peppapighs/HE16/HE16/HE16.kicad_pcb

## KiCad design HE16/HE16.kicad_pcb (2025-07-30)

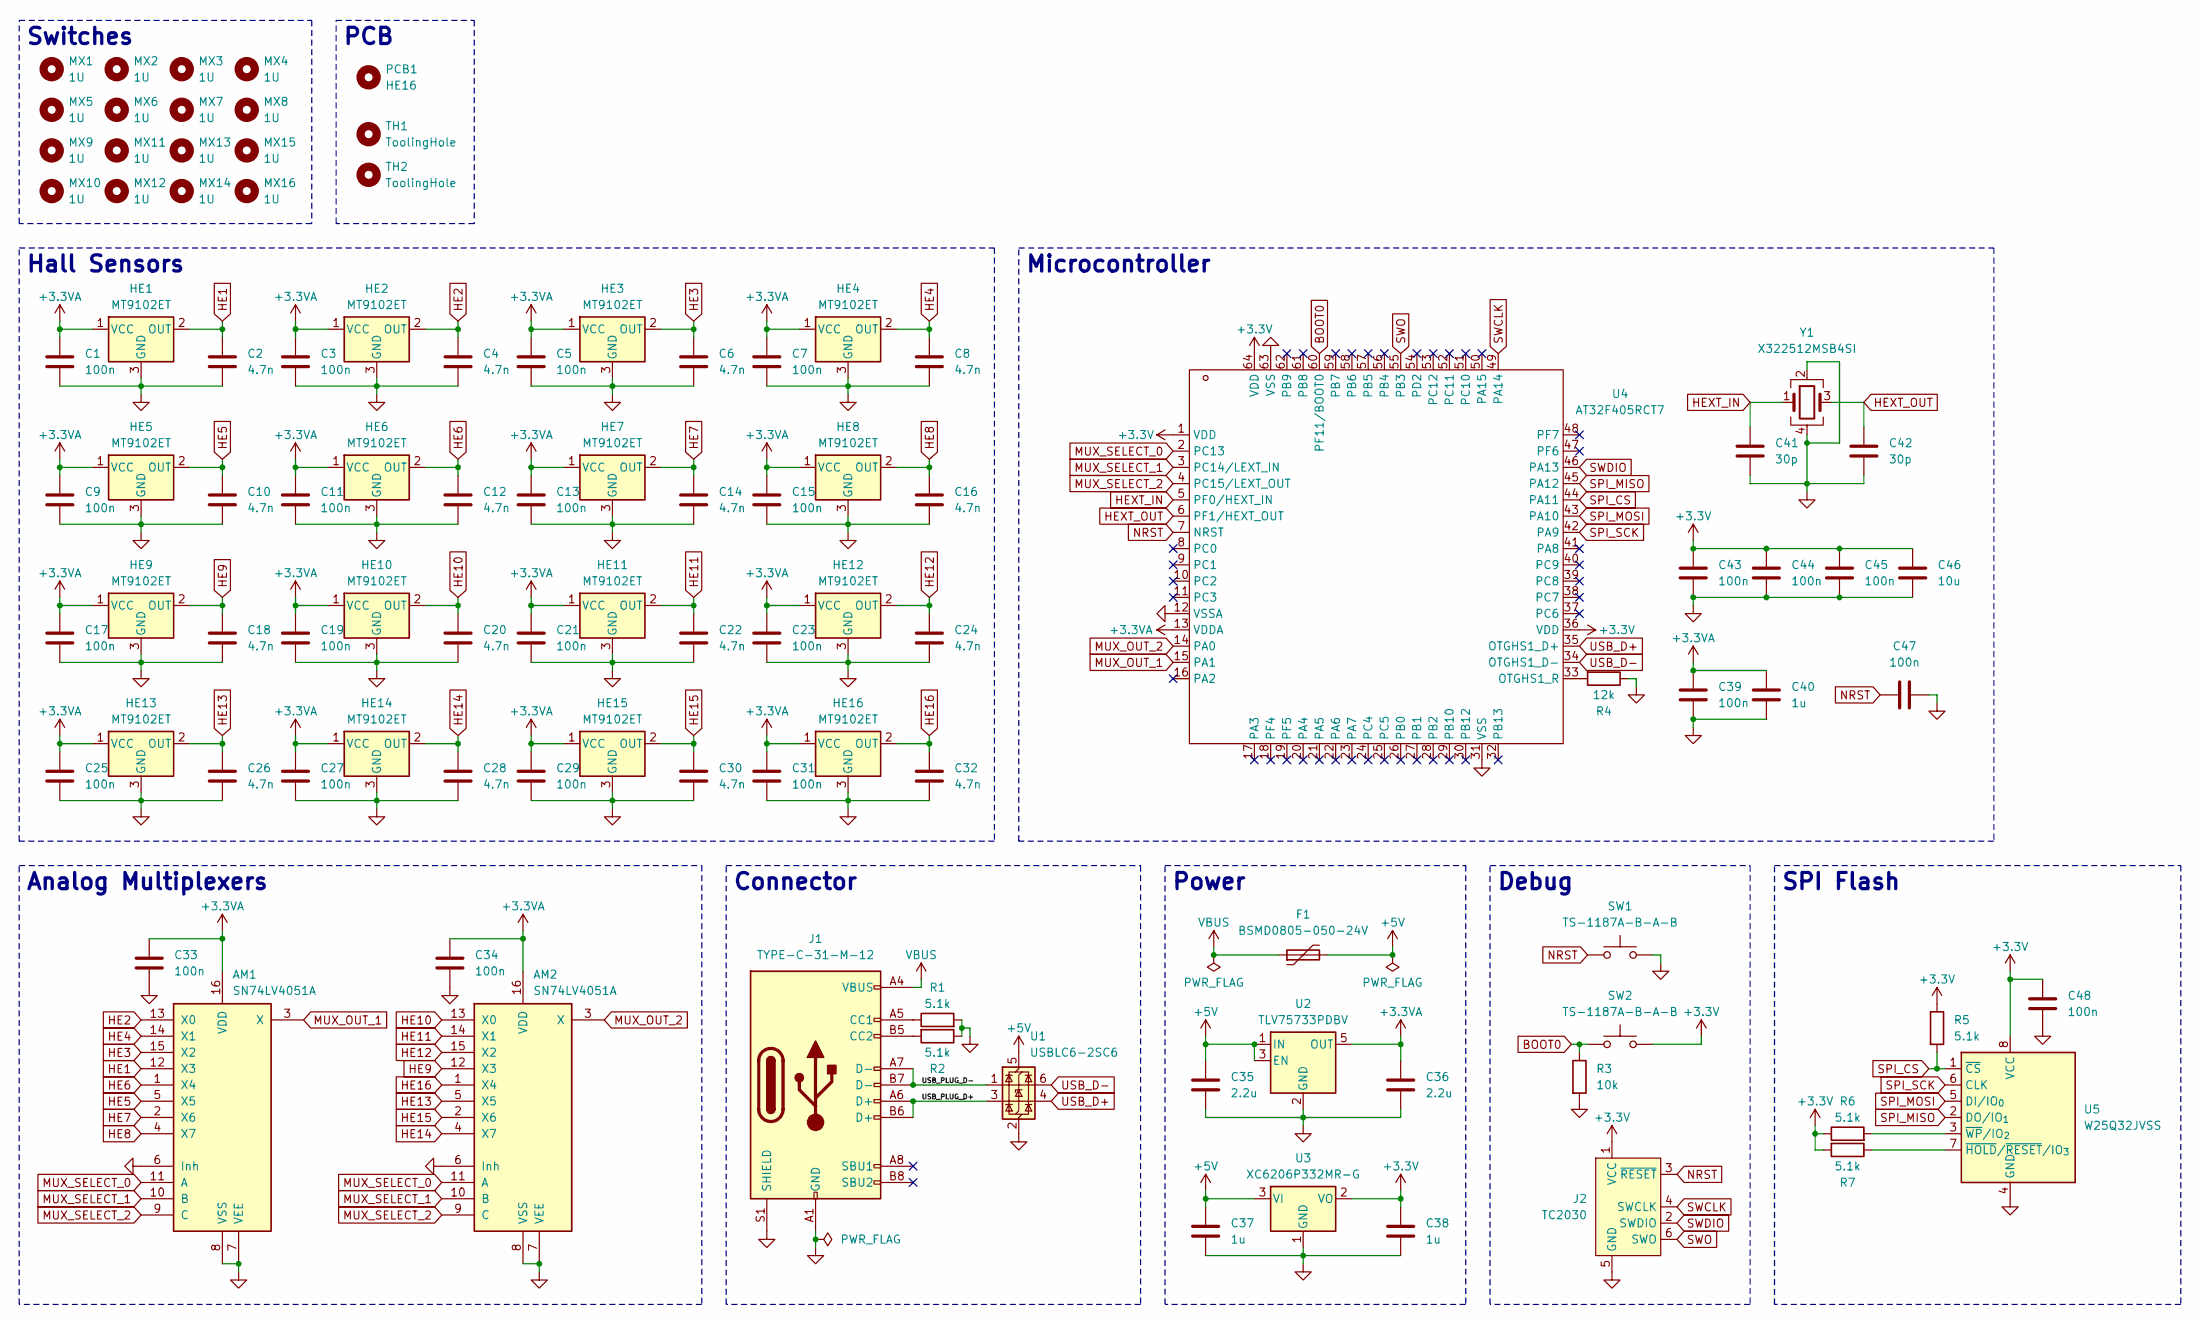
[picture p1: schematic HE16.kicad_sch]

Parts:
AM1, AM2: SN74LV4051A; TSSOP-16_4.4x5mm_P0.65mm
C1, C3, C5, C7, C9, C11, C13, C15, C17, C19, C21, C23, C25, C27, C29, C31, C33, C34, C39, C43, C44, C45, C47, C48: 100n; C_0402_1005Metric
C2, C4, C6, C8, C10, C12, C14, C16, C18, C20, C22, C24, C26, C28, C30, C32: 4.7n; C_0402_1005Metric
C35, C36: 2.2u; C_0603_1608Metric
C37, C38, C40: 1u; C_0603_1608Metric
C41, C42: 30p; C_0603_1608Metric
C46: 10u; C_0603_1608Metric
F1: BSMD0805-050-24V; Fuse_0805_2012Metric
HE1, HE2, HE3, HE4, HE5, HE6, HE7, HE8, HE9, HE10, HE11, HE12, HE13, HE14, HE15, HE16: MT9102ET; SOT-23-3
J1: TYPE-C-31-M-12; USB_C_Receptacle_HRO_TYPE-C-31-M-12
J2: TC2030; Tag-Connect_TC2030-IDC-FP_2x03_P1.27mm_Vertical
MX1, MX2, MX3, MX4, MX5, MX6, MX7, MX8, MX9, MX10, MX11, MX12, MX13, MX14, MX15, MX16: 1U; MX-1U
PCB1: HE16
R1, R2, R5, R6, R7: 5.1k; R_0402_1005Metric
R3: 10k; R_0402_1005Metric
R4: 12k; R_0402_1005Metric
SW1, SW2: TS-1187A-B-A-B; SW_Push_1P1T_XKB_TS-1187A
TH1, TH2: ToolingHole
U1: USBLC6-2SC6; SOT-23-6
U2: TLV75733PDBV; SOT-23-5
U3: XC6206P332MR-G; SOT-23-3
U4: AT32F405RCT7; LQFP-64_10x10mm_P0.5mm
U5: W25Q32JVSS; SOIC-8_5.3x5.3mm_P1.27mm
Y1: X322512MSB4SI; Crystal_SMD_3225-4Pin_3.2x2.5mm

Connections:
+3.3V: C38.1, C43.1, C44.1, C45.1, C46.1, C48.1, J2.1 (VCC), R5.1, R6.1, R7.2, SW2.2, U3.2 (VO), U4.1 (VDD), U4.36 (VDD), U4.64 (VDD), U5.8 (VCC)
+3.3VA: AM1.16 (VDD), AM2.16 (VDD), C1.1, C3.1, C5.1, C7.1, C9.1, C11.1, C13.1, C15.1, C17.1, C19.1, C21.1, C23.1, C25.1, C27.1, C29.1, C31.1, C33.1, C34.1, C36.1, C39.1, C40.1, HE1.1 (VCC), HE2.1 (VCC), HE3.1 (VCC), HE4.1 (VCC), HE5.1 (VCC), HE6.1 (VCC), HE7.1 (VCC), HE8.1 (VCC), HE9.1 (VCC), HE10.1 (VCC), HE11.1 (VCC), HE12.1 (VCC), HE13.1 (VCC), HE14.1 (VCC), HE15.1 (VCC), HE16.1 (VCC), U2.5 (OUT), U4.13 (VDDA)
+5V: C35.1, C37.1, F1.2, U1.5 (VBUS), U2.1 (IN), U2.3 (EN), U3.3 (VI)
/USB_PLUG_D+: J1.A6 (D+), J1.B6 (D+), U1.3 (I/O2)
/USB_PLUG_D-: J1.A7 (D-), J1.B7 (D-), U1.1 (I/O1)
BOOT0: R3.1, SW2.1, U4.60 (PF11/BOOT0)
GND: AM1.6 (Inh), AM1.7 (VEE), AM1.8 (VSS), AM2.6 (Inh), AM2.7 (VEE), AM2.8 (VSS), C1.2, C2.2, C3.2, C4.2, C5.2, C6.2, C7.2, C8.2, C9.2, C10.2, C11.2, C12.2, C13.2, C14.2, C15.2, C16.2, C17.2, C18.2, C19.2, C20.2, C21.2, C22.2, C23.2, C24.2, C25.2, C26.2, C27.2, C28.2, C29.2, C30.2, C31.2, C32.2, C33.2, C34.2, C35.2, C36.2, C37.2, C38.2, C39.2, C40.2, C41.2, C42.2, C43.2, C44.2, C45.2, C46.2, C47.2, C48.2, HE1.3 (GND), HE2.3 (GND), HE3.3 (GND), HE4.3 (GND), HE5.3 (GND), HE6.3 (GND), HE7.3 (GND), HE8.3 (GND), HE9.3 (GND), HE10.3 (GND), HE11.3 (GND), HE12.3 (GND), HE13.3 (GND), HE14.3 (GND), HE15.3 (GND), HE16.3 (GND), J1.A1 (GND), J1.A12 (GND), J1.B1 (GND), J1.B12 (GND), J1.S1 (SHIELD), J2.5 (GND), R1.2, R2.1, R3.2, R4.1, SW1.2, U1.2 (GND), U2.2 (GND), U3.1 (GND), U4.12 (VSSA), U4.31 (VSS), U4.63 (VSS), U5.4 (GND), Y1.2, Y1.4
HE1: AM1.12 (X3), C2.1, HE1.2 (OUT)
HE2: AM1.13 (X0), C4.1, HE2.2 (OUT)
HE3: AM1.15 (X2), C6.1, HE3.2 (OUT)
HE4: AM1.14 (X1), C8.1, HE4.2 (OUT)
HE5: AM1.5 (X5), C10.1, HE5.2 (OUT)
HE6: AM1.1 (X4), C12.1, HE6.2 (OUT)
HE7: AM1.2 (X6), C14.1, HE7.2 (OUT)
HE8: AM1.4 (X7), C16.1, HE8.2 (OUT)
HE9: AM2.12 (X3), C18.1, HE9.2 (OUT)
HE10: AM2.13 (X0), C20.1, HE10.2 (OUT)
HE11: AM2.14 (X1), C22.1, HE11.2 (OUT)
HE12: AM2.15 (X2), C24.1, HE12.2 (OUT)
HE13: AM2.5 (X5), C26.1, HE13.2 (OUT)
HE14: AM2.4 (X7), C28.1, HE14.2 (OUT)
HE15: AM2.2 (X6), C30.1, HE15.2 (OUT)
HE16: AM2.1 (X4), C32.1, HE16.2 (OUT)
HEXT_IN: C41.1, U4.5 (PF0/HEXT_IN), Y1.1
HEXT_OUT: C42.1, U4.6 (PF1/HEXT_OUT), Y1.3
MUX_OUT_1: AM1.3 (X), U4.15 (PA1)
MUX_OUT_2: AM2.3 (X), U4.14 (PA0)
MUX_SELECT_0: AM1.11 (A), AM2.11 (A), U4.2 (PC13)
MUX_SELECT_1: AM1.10 (B), AM2.10 (B), U4.3 (PC14/LEXT_IN)
MUX_SELECT_2: AM1.9 (C), AM2.9 (C), U4.4 (PC15/LEXT_OUT)
NRST: C47.1, J2.3 (~RESET), SW1.1, U4.7 (NRST)
unnamed: J1.A5 (CC1), R1.1
unnamed: J1.B5 (CC2), R2.2
unnamed: R4.2, U4.33 (OTGHS1_R)
unnamed: R7.1, U5.7 (~HOLD/~RESET/IO_{3})
unnamed: R6.2, U5.3 (~WP/IO_{2})
SPI_CS: R5.2, U4.44 (PA11), U5.1 (~CS)
SPI_MISO: U4.45 (PA12), U5.2 (DO/IO_{1})
SPI_MOSI: U4.43 (PA10), U5.5 (DI/IO_{0})
SPI_SCK: U4.42 (PA9), U5.6 (CLK)
SWCLK: J2.4 (SWCLK), U4.49 (PA14)
SWDIO: J2.2 (SWDIO), U4.46 (PA13)
SWO: J2.6 (SWO), U4.55 (PB3)
USB_D+: U1.4 (I/O2), U4.35 (OTGHS1_D+)
USB_D-: U1.6 (I/O1), U4.34 (OTGHS1_D-)
VBUS: F1.1, J1.A4 (VBUS), J1.A9 (VBUS), J1.B4 (VBUS), J1.B9 (VBUS)

Notes on the sheet:
Switches
Connector
Debug
Microcontroller
Analog Multiplexers
Hall Sensors
PCB
SPI Flash
Power

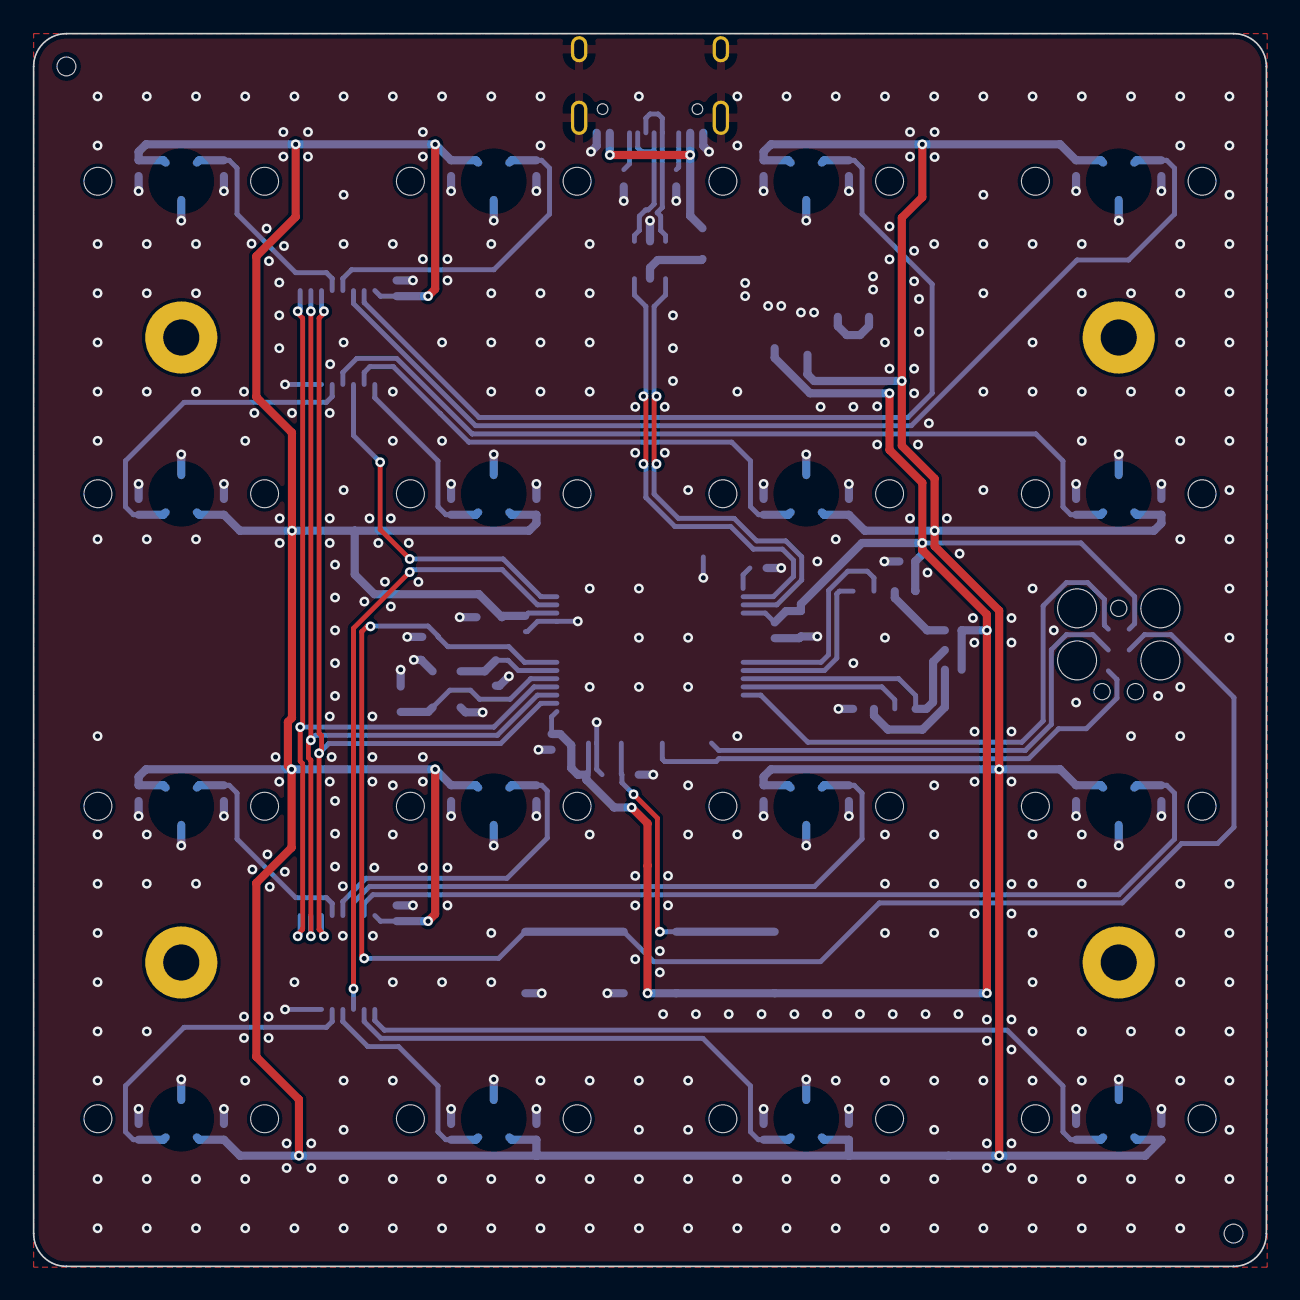
[picture p2: board HE16.kicad_pcb from above]

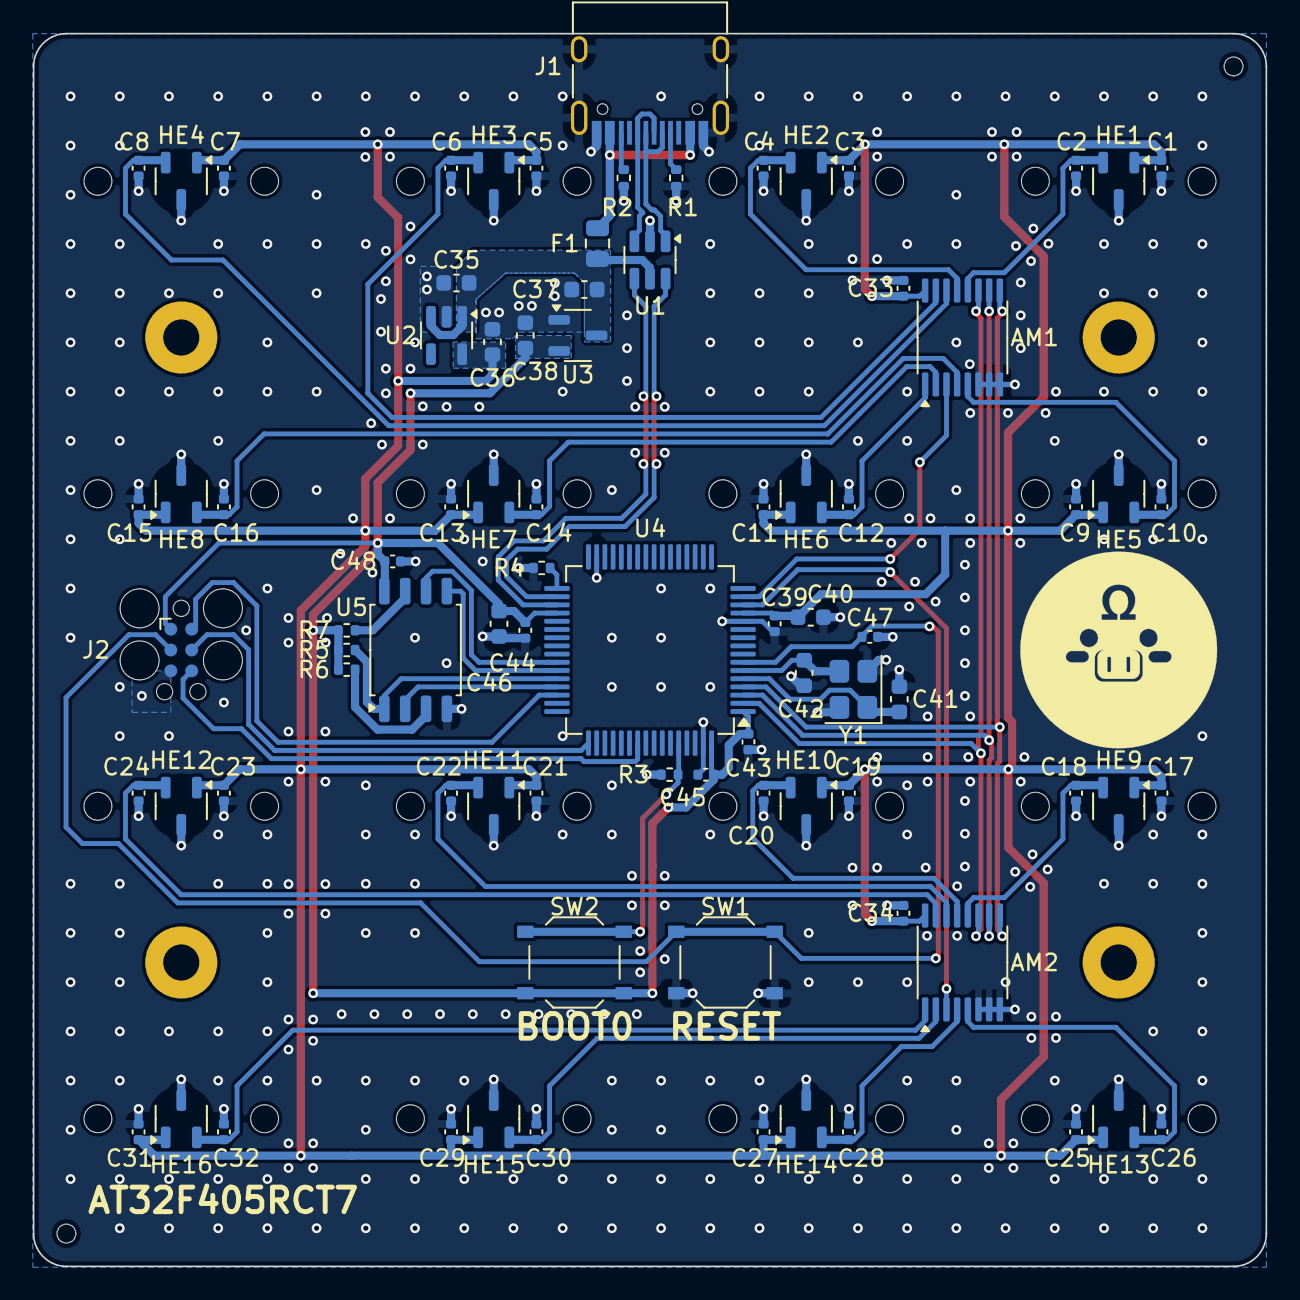
[picture p3: board HE16.kicad_pcb from below]

Board: 2 copper layers, 75.2 x 75.2 mm, 103 parts (86 on the bottom side), 46 nets.
